neogeek83/CarMonitor/docs/Arduino_Schematic.png

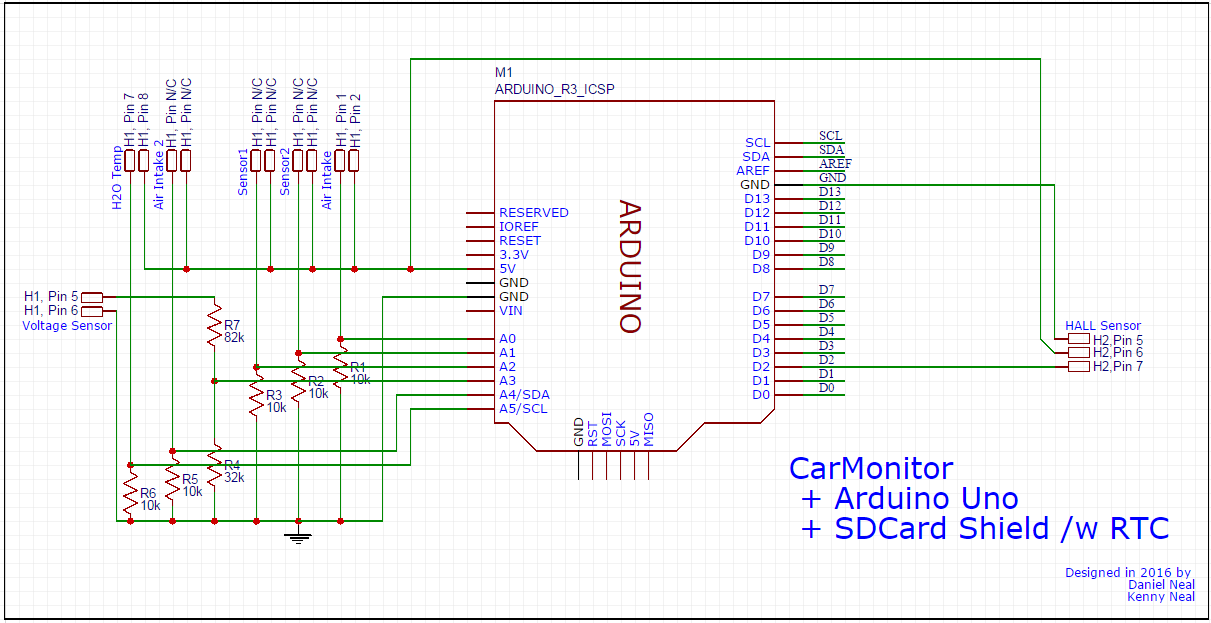
docs/Arduino_Schematic.png
