neogeek83/CarMonitor/docs/resistor-color-chart.jpg

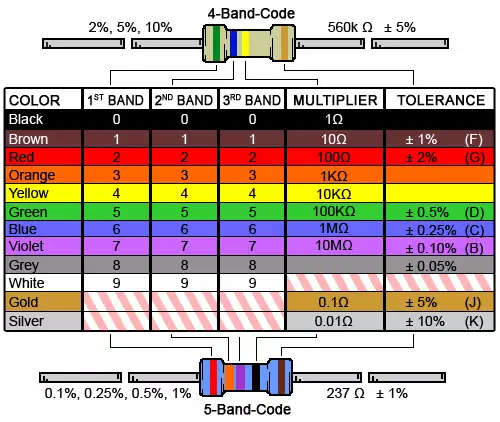
docs/resistor-color-chart.jpg
