neogeek83/CarMonitor/docs/Arduino_Schematic.pdf

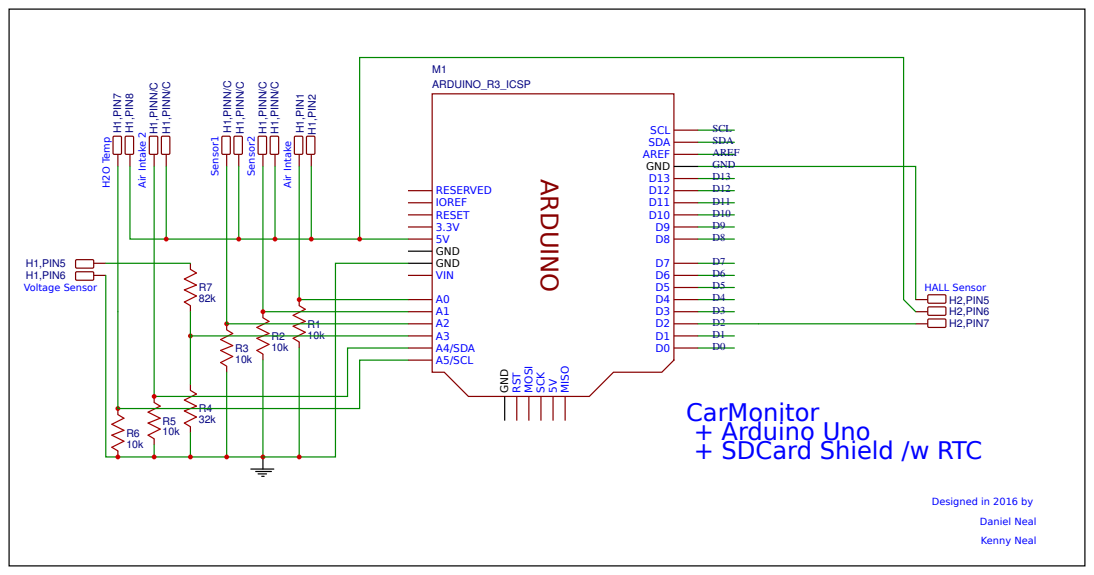
[picture p4: page 1]
