neogeek83/CarMonitor/docs/1978-79.5-triumph-spitfire-wiring-diagram.jpg

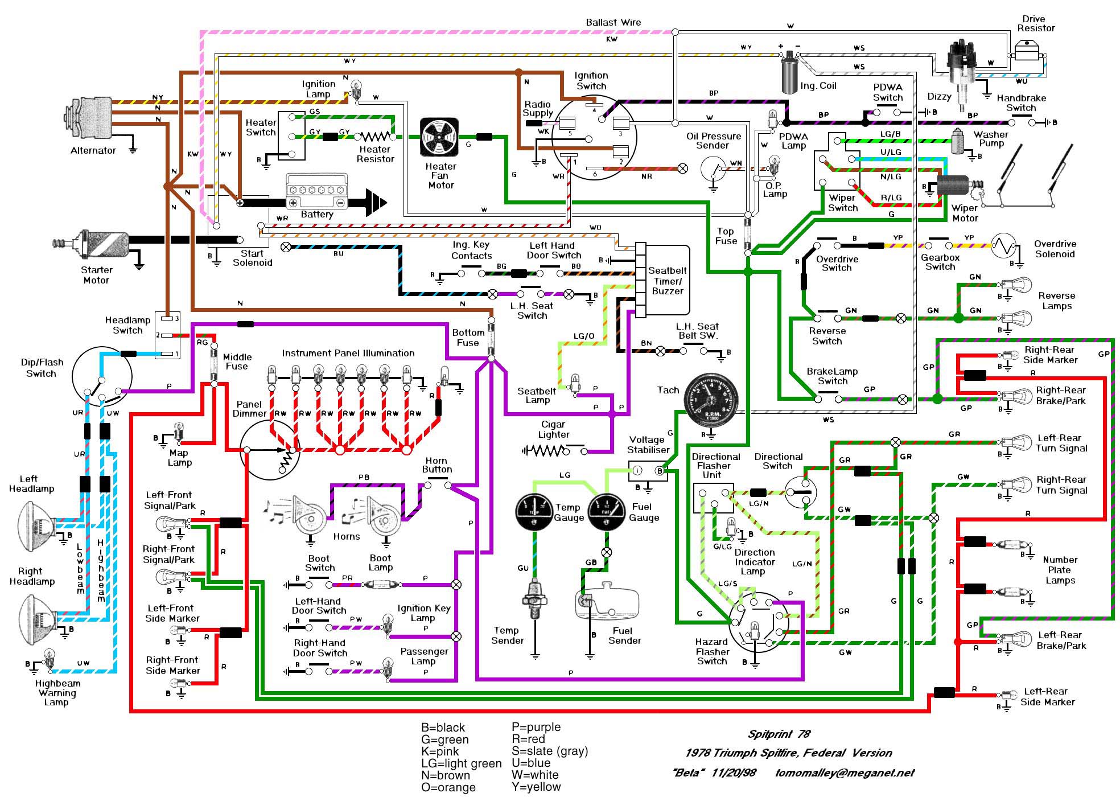
docs/1978-79.5-triumph-spitfire-wiring-diagram.jpg
