neogeek83/CarMonitor/docs/Sensor_Calibration.xlsx

Note all voltages are referenced to ground when wired into the circuit show in sensor_wiring.png
Black BMW Air Temp Sensor (AITS) |  | Temp | 98.5 | 75 | 61.5 |  |  |  |  |  |  |  |  |  |  | Slope | -0.008641293727 | sensor reading: | 6542
13.62-1 739 510 |  | Arduino Reading | 3066.1 | 5260 | 7355.93 |  |  |  |  |  |  |  |  |  |  | X-intercept | 123.5043425 | predicted temp | 66.97299893
 |  |  | Arduino Reading
 |  | room temp | 7150
 |  | room temp after breathing | 7070
 |  | held to laptop exhaust | 3900
 |  | room temp after laptop | 6770
 |  | armpit stabilized | 3094
Yellow BMW Temp Air Sensor ( 1 383 204) |  | Temp | 118.8 | 112 | 110 | 72.7 | 70.6 |  |  |  |  |  |  |  |  | Slope | -0.1124444493 | sensor reading: | 1500
* 3.5kohms ~65degrees |  | Arduino Reading | 1070.27 | 1154.68 | 1191.26 | 1492.71 | 1518.56 |  |  |  |  |  |  |  |  | X-intercept | 241.3668899 | predicted temp | 72.70021584
BMW Water Temp Sensor(1 703 998) |  | Temp | 133.9 | 133.3 | 132.5 | 130 | 125 | 120 | 115 | 105 | 100 | 95 | 90 | 86.6 | 75 | Slope | -0.09459162377 | sensor reading: | 1080
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
