neogeek83/CarMonitor/CarMonitor/sensor_readings/LOGGER05_baseline_issue_didnt_occur.CSV

Time since engine start(millis) | Unix Epoch Timestamp | Date/Time | unused | AITS (blackair) | unused | unused | unused | Battery Voltage(~12v) | unused | unused | unused | unused | unused | RPM
1999 | 1478549964 | 2016/11/7 20:19:24 | 3.21 | 75.24 |  |  | 3.49 | 12.09 | 4.16 | 12.33 | 4.16 | -8.45 |  | 0
2999 | 1478549965 | 2016/11/7 20:19:25 | 3.21 | 75.24 |  |  | 3.52 | 12.19 | 4.16 | 12.33 | 4.16 | -8.45 |  | 0
3999 | 1478549966 | 2016/11/7 20:19:26 | 3.21 | 75.24 |  |  | 3.52 | 12.19 | 4.16 | 12.33 | 4.16 | -8.45 |  | 0
5000 | 1478549967 | 2016/11/7 20:19:27 | 3.21 | 75.24 |  |  | 3.52 | 12.19 | 4.16 | 12.33 | 4.16 | -8.45 |  | 0
5999 | 1478549968 | 2016/11/7 20:19:28 | 3.20 | 75.04 |  |  | 3.52 | 12.19 | 4.16 | 12.33 | 4.16 | -8.45 |  | 0
6999 | 1478549969 | 2016/11/7 20:19:29 | 3.20 | 75.04 |  |  | 3.49 | 12.09 | 4.16 | 12.33 | 4.15 | -9.79 |  | 0
7999 | 1478549970 | 2016/11/7 20:19:30 | 3.21 | 75.24 |  |  | 3.52 | 12.19 | 4.16 | 12.33 | 4.16 | -8.45 |  | 0
8998 | 1478549971 | 2016/11/7 20:19:31 | 3.20 | 75.04 |  |  | 3.52 | 12.21 | 4.16 | 12.33 | 4.16 | -8.45 |  | 0
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
