neogeek83/CarMonitor/CarMonitor/sensor_readings/LOGGER05_baseline_issue_didnt_occur(formatted).xlsx

stamp | blackair | 12v | rpm
1478549964 | 75.24 | 12.09 | 0
1478549965 | 75.24 | 12.19 | 0
1478549966 | 75.24 | 12.19 | 0
1478549967 | 75.24 | 12.19 | 0
1478549968 | 75.04 | 12.19 | 0
1478549969 | 75.04 | 12.09 | 0
1478549970 | 75.24 | 12.19 | 0
1478549971 | 75.04 | 12.21 | 0
1478549972 | 75.04 | 12.19 | 0
1478549973 | 75.04 | 10.84 | 0
1478549974 | 74.83 | 11.89 | 0
1478549975 | 74.83 | 12.7 | 66
1478549976 | 75.45 | 13.55 | 930
1478549977 | 76.06 | 13.96 | 899
1478549978 | 76.66 | 13.92 | 986
1478549979 | 76.66 | 13.94 | 1044
1478549980 | 77.26 | 13.89 | 1102
1478549981 | 77.66 | 13.99 | 1015
1478549982 | 77.85 | 13.97 | 1020
1478549983 | 78.25 | 14.07 | 1015
1478549984 | 78.05 | 14.04 | 1073
1478549985 | 78.64 | 14.04 | 1110
1478549986 | 78.64 | 13.96 | 1140
1478549987 | 78.83 | 14.12 | 1131
1478549988 | 78.83 | 14.07 | 1140
1478549989 | 79.03 | 14.19 | 1131
1478549990 | 79.41 | 14.18 | 1131
1478549991 | 79.6 | 14.14 | 1200
1478549992 | 79.8 | 14.06 | 1160
1478549993 | 79.99 | 14.12 | 1170
1478549994 | 80.18 | 13.9 | 1189
1478549995 | 80.37 | 14.07 | 1131
1478549996 | 80.37 | 14.07 | 1170
1478549997 | 80.37 | 13.97 | 1170
1478549998 | 80.56 | 14.04 | 1102
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
