neogeek83/CarMonitor/(commit log)

2016-02-28 Update README.md
    Added sensor measurements
2016-03-01 Adding some basic Sketches and docs
    [Sensor log.xlsx]
2016-03-22 Fixed sensor readings to read correct resistance (problem was with voltage calculations), templated correction tables to get accurate temperatures, and calibrated sensors from ~72-120f.
    [Sensor Readings.xlsx]
2016-03-22 Recommitting missing files from previous commit
    [CarMonitor.ino, ImpedanceTester.ino]
2016-03-29 Adding volt meter code (uses a 85k and 33k resistor)
2016-05-02 Added RPM monitor using hall effect sensor from DC fan. Model FTC-S211 4df.
2016-05-02 Added wiring diagram for a 76 Spitfire
2016-05-02 Adding pin info for hall sensor(+5v, Gnd, sensor to digital pin 2)
2016-07-25 Cleanup docs
    [Sensor Readings.xlsx]
2016-07-26 Adding correct wiring diagram, we had the 1976, which is different in the coil area we care about!
2016-09-19 Updated TODO to include wiring
2016-09-20 added wiring section, pinouts, and link to pictures
2016-10-10 Adding resistor coloring chart and updated sensor readings.
    [Sensor Readings.xlsx]
2016-10-10 Adding labels to serial output, adding Setting functionality for RTC, and updating README for pin info
2016-10-25 Added Hall Effect sensor spec sheets and updated README todos plus harness #2 pinout
2016-10-31 Adding hall effect test and wiring pics
2016-10-31 Fixing issue with filenames larger than 99
    [CarMonitor.ino]
2016-11-07 another fix for filenaming, trying sprintf
    [CarMonitor.ino]
2016-11-08 Adding sensor reading from last 2 weeks
    [LOGGER00.xlsx, LOGGER05_baseline_issue_didnt_occur.CSV]
2016-11-08 fixing the file roll thing
    [CarMonitor.ino]
2016-11-08 added a formatted excel file with ranging and a chart
    [LOGGER05_baseline_issue_didnt_occur(formatted).xlsx]
2016-11-08 adding pics of wiring harness
2016-11-26 Updating Readme and sensor logging
    [Sensor Readings.xlsx, Sensor log.xlsx, Sensor_Calibration.xlsx]
2016-11-26 Fixing missing comma in output to SDCard after timestamp
    [CarMonitor.ino]
2016-11-26 Fixing issue with data output format
    [LOGGER05_baseline_issue_didnt_occur.CSV]
2016-11-26 Updating README with backstory, typos, and sample output CSV reference
2016-11-26 fixing issue with output formatting
    [LOGGER05_baseline_issue_didnt_occur.CSV]
2016-11-27 Updating docs and adding schematic
